melrouts/RetroConsole-LunaStation/exhibition/shot-apollo.png

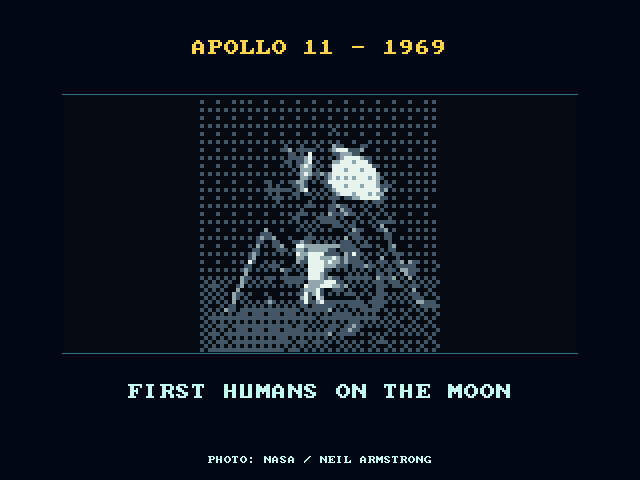
exhibition/shot-apollo.png
