melrouts/RetroConsole-LunaStation/hardware/board-photos/IMG_6732.jpeg

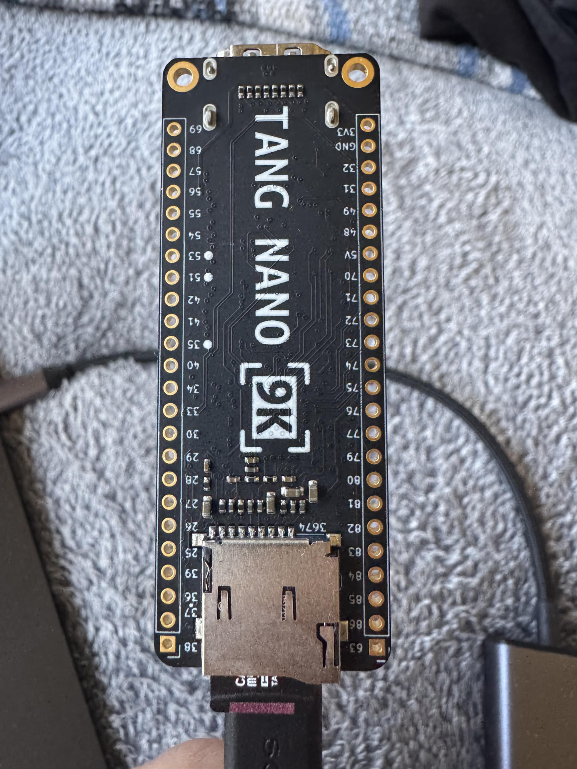
hardware/board-photos/IMG_6732.jpeg
