melrouts/RetroConsole-LunaStation/hardware/esp32-max98357a/photos/IMG_6813.jpeg

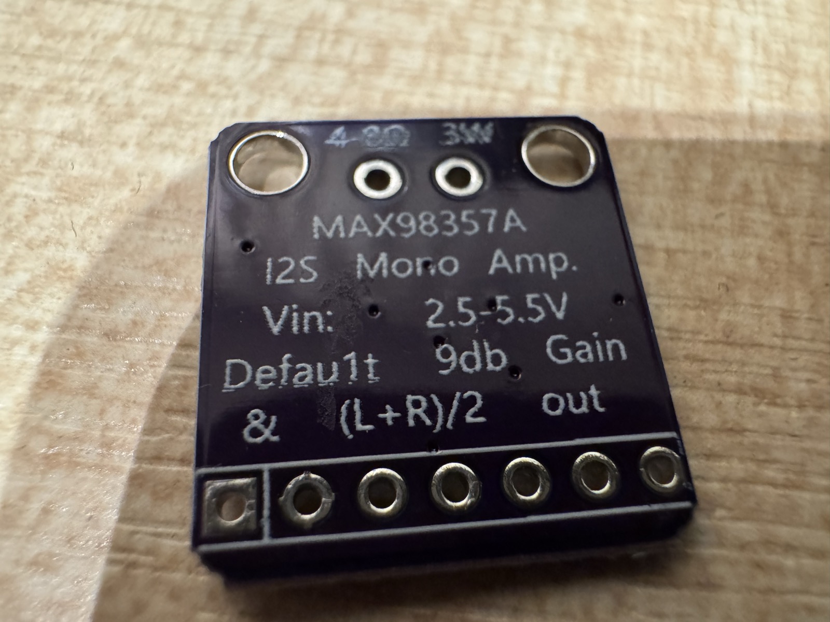
hardware/esp32-max98357a/photos/IMG_6813.jpeg
