melrouts/RetroConsole-LunaStation/hardware/luna-station-case/v1/previews/base_bottom.png

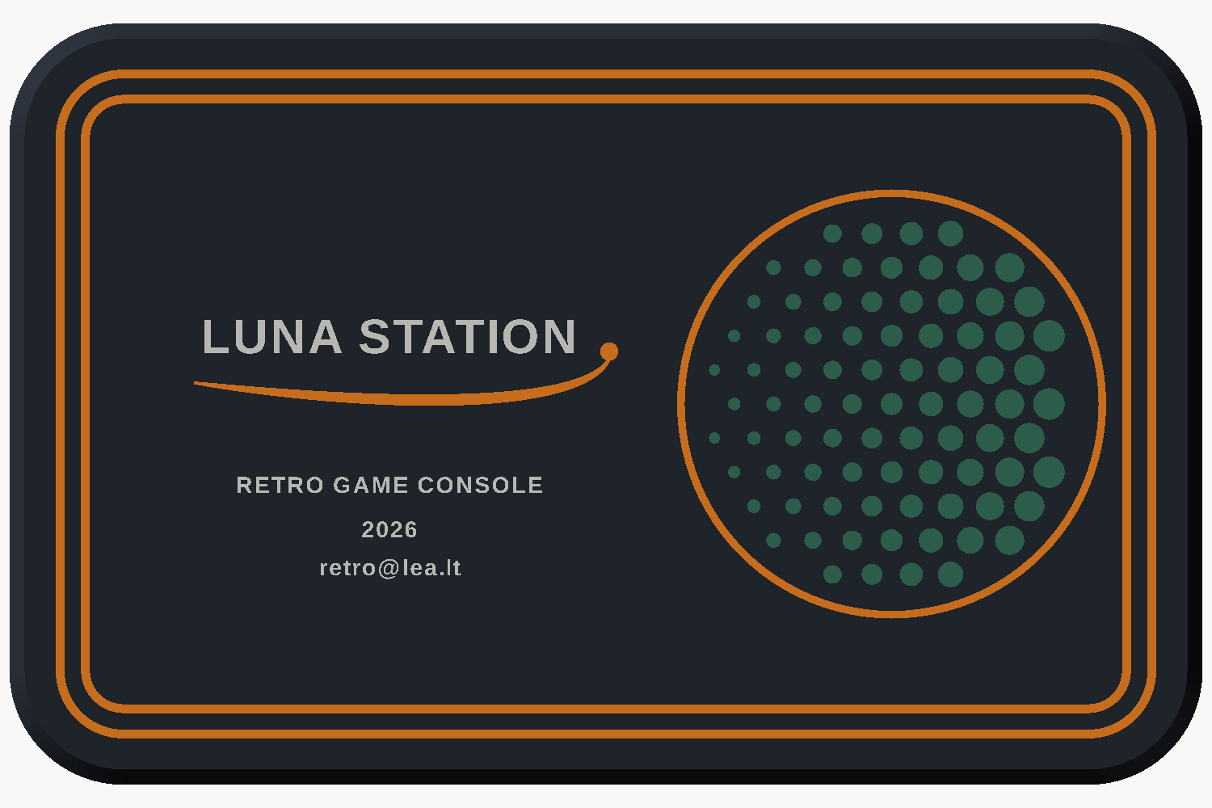
hardware/luna-station-case/v1/previews/base_bottom.png
