melrouts/RetroConsole-LunaStation/hardware/luna-station-case/v1/previews/base_options.png

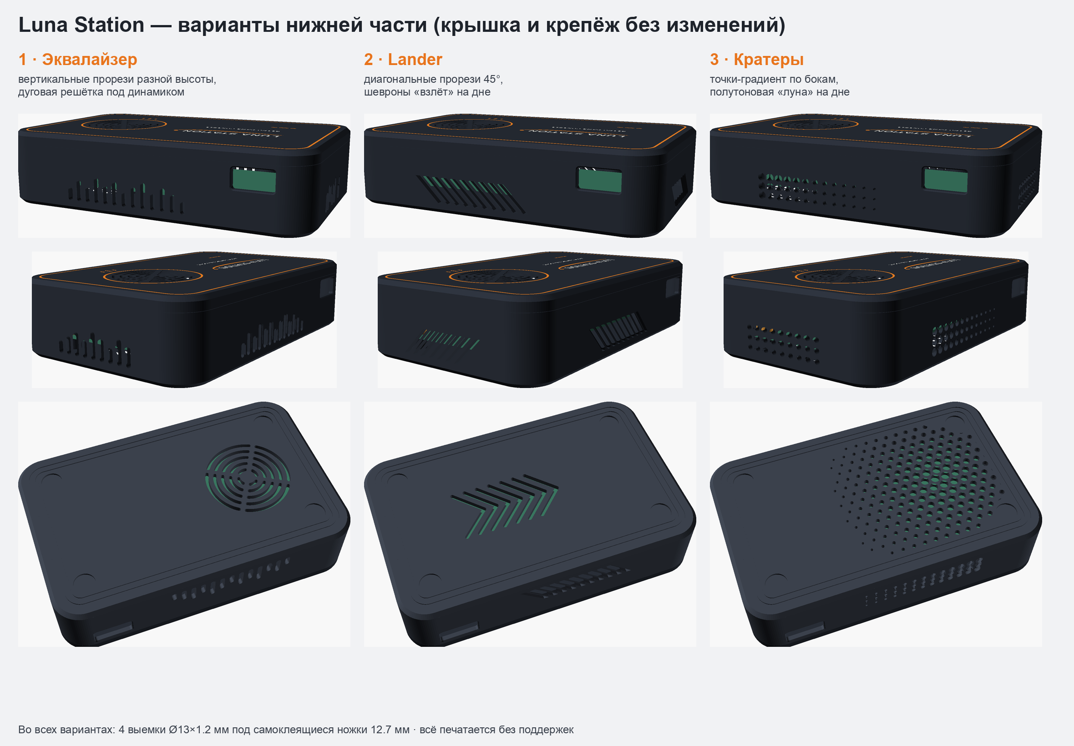
hardware/luna-station-case/v1/previews/base_options.png
