melrouts/RetroConsole-LunaStation/hardware/luna-station-case/v1/previews/base_side.png

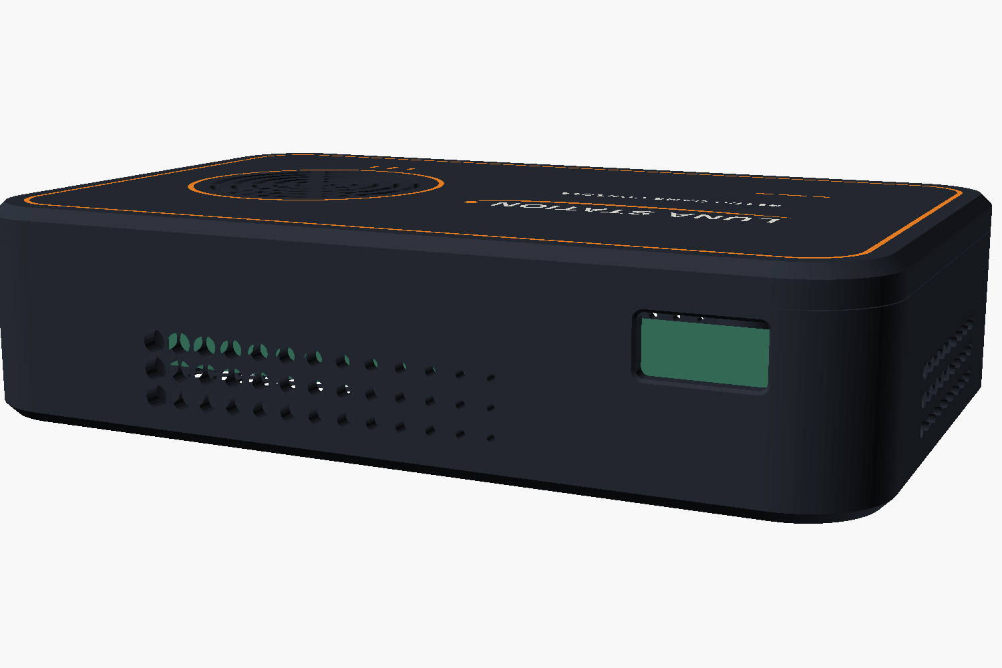
hardware/luna-station-case/v1/previews/base_side.png
