melrouts/RetroConsole-LunaStation/hardware/luna-station-case/v1/previews/base_under.png

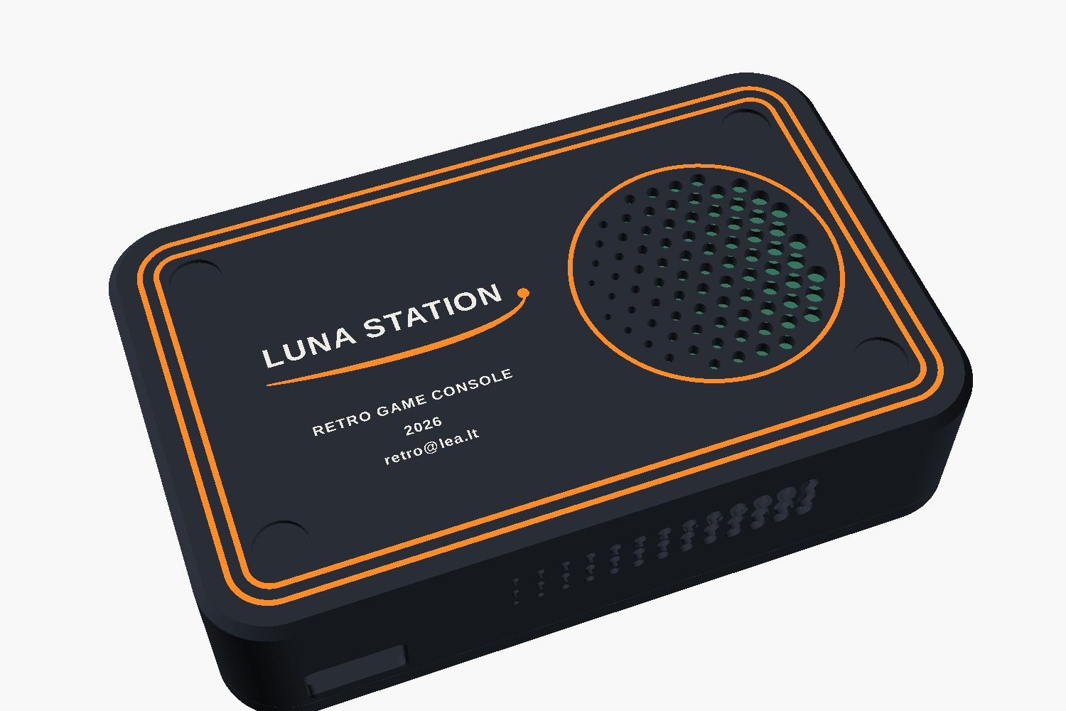
hardware/luna-station-case/v1/previews/base_under.png
