melrouts/RetroConsole-LunaStation/hardware/luna-station-case/v1/previews/fit_iso.png

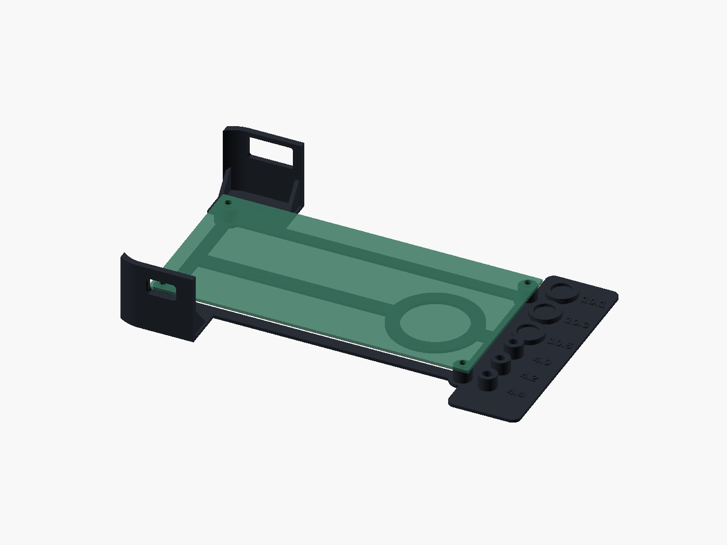
hardware/luna-station-case/v1/previews/fit_iso.png
