melrouts/RetroConsole-LunaStation/hardware/luna-station-case/v1/previews/fit_top.png

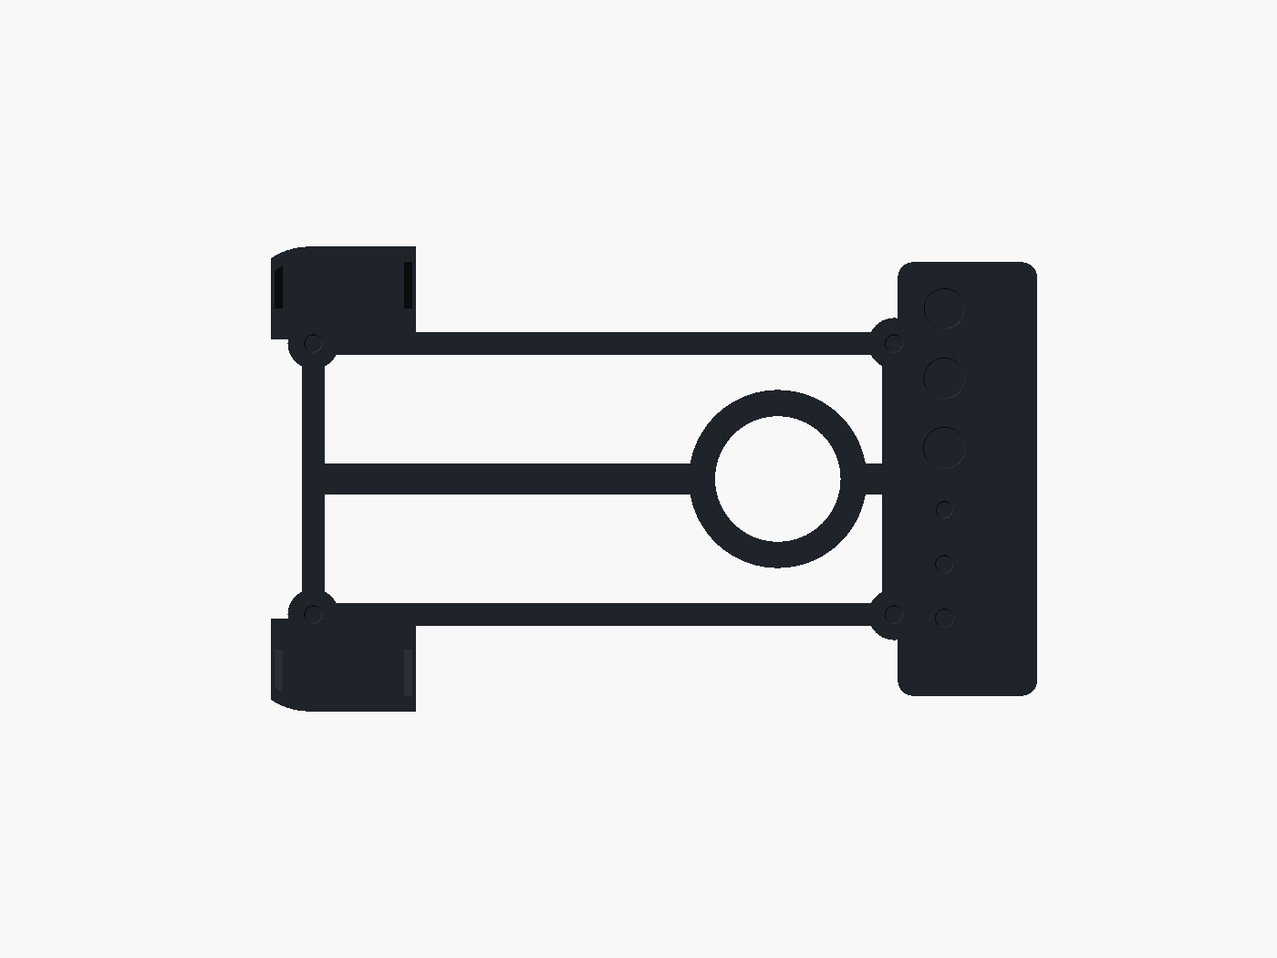
hardware/luna-station-case/v1/previews/fit_top.png
