melrouts/RetroConsole-LunaStation/hardware/luna-station-case/v1/previews/port_hdmi.png

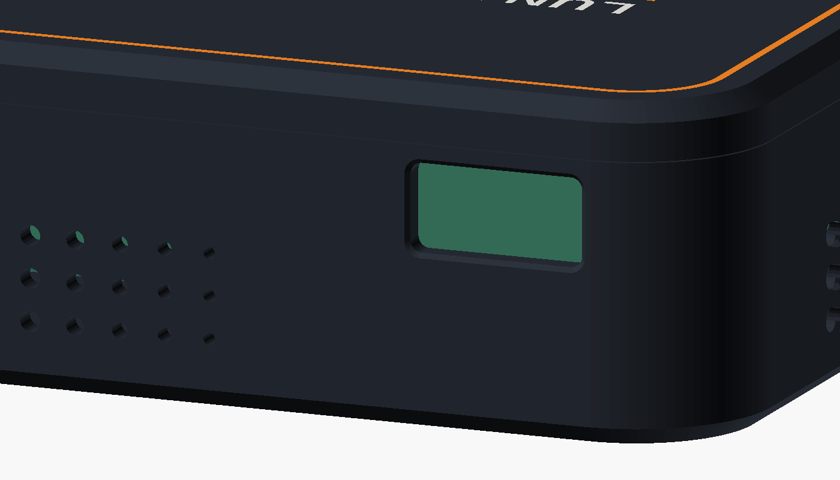
hardware/luna-station-case/v1/previews/port_hdmi.png
