melrouts/RetroConsole-LunaStation/hardware/luna-station-case/v1/previews/port_top.png

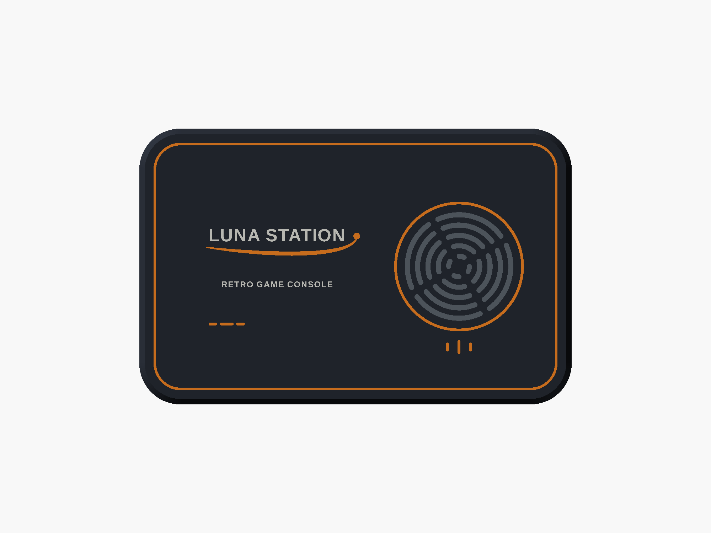
hardware/luna-station-case/v1/previews/port_top.png
