melrouts/RetroConsole-LunaStation/hardware/luna-station-case/v1/previews/port_usb_c.png

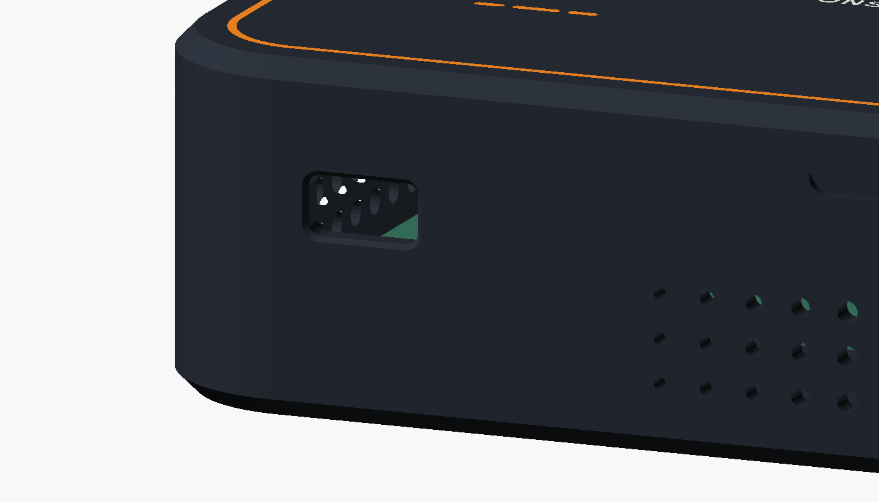
hardware/luna-station-case/v1/previews/port_usb_c.png
