melrouts/RetroConsole-LunaStation/hardware/luna-station-case/v1/previews/section.png

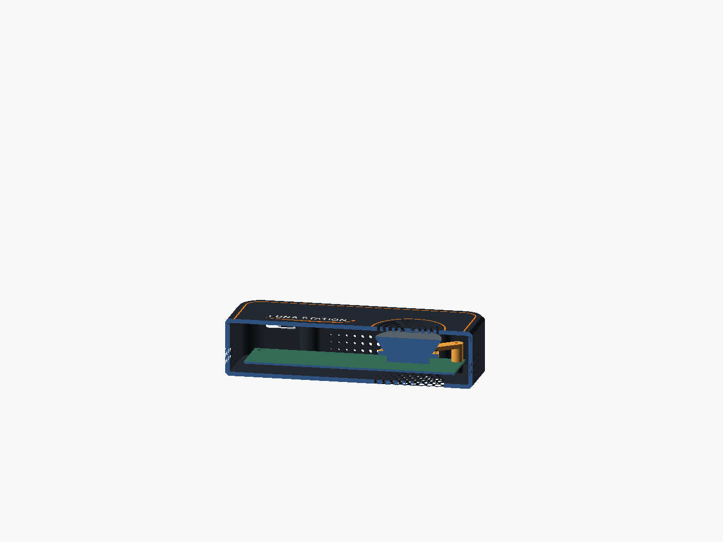
hardware/luna-station-case/v1/previews/section.png
