melrouts/RetroConsole-LunaStation/hardware/luna-station-case/v1/previews/variant_2_iso.png

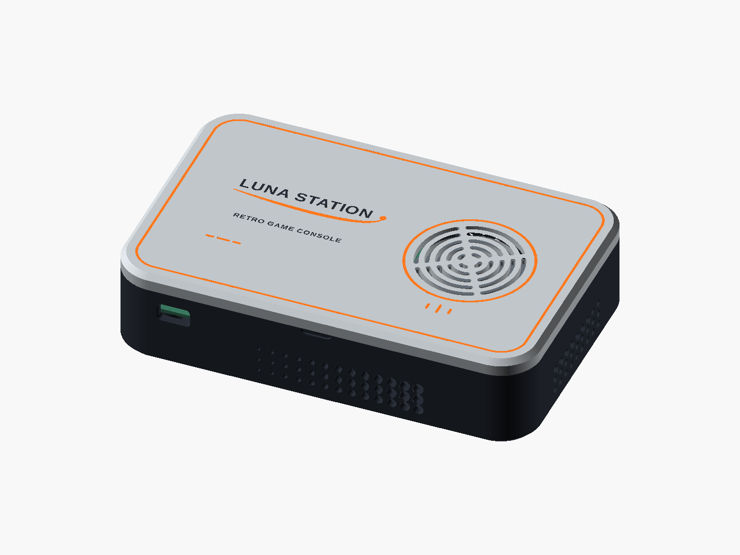
hardware/luna-station-case/v1/previews/variant_2_iso.png
