melrouts/RetroConsole-LunaStation/IMG_6783.jpeg

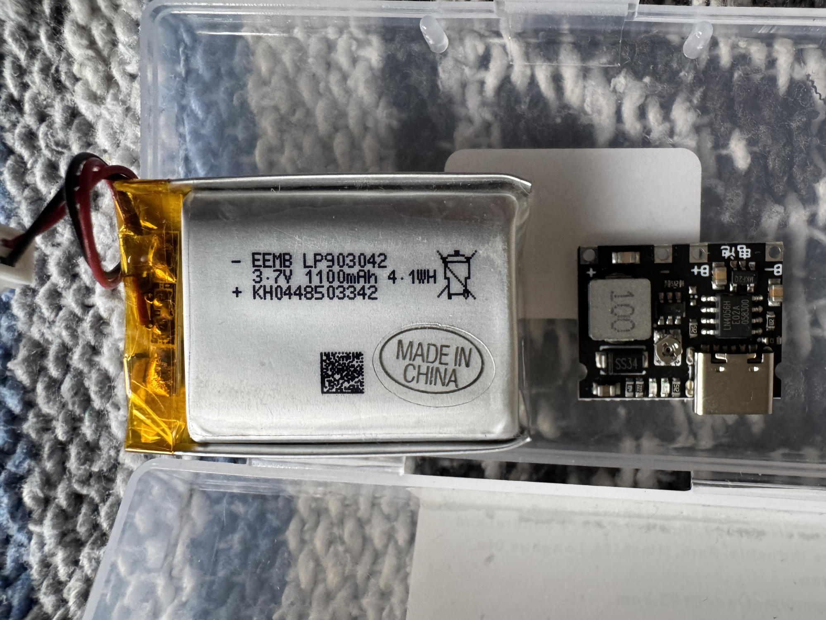
IMG_6783.jpeg
