melrouts/RetroConsole-LunaStation/photos/apollo11-nasa-6900956.jpg

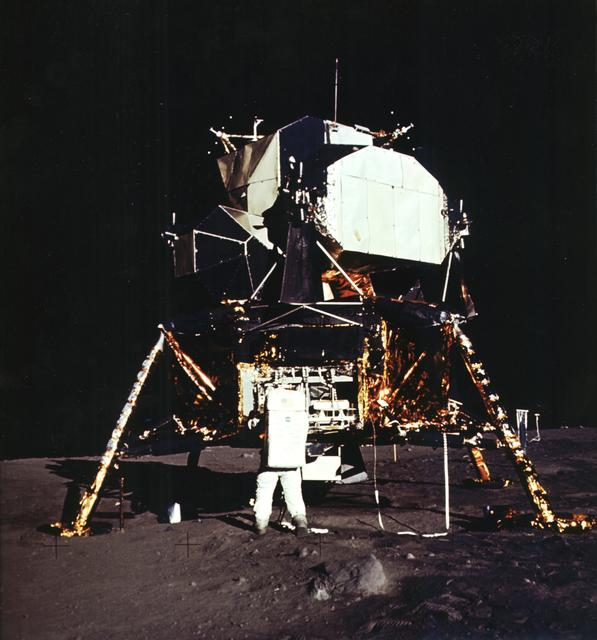
photos/apollo11-nasa-6900956.jpg
