melrouts/RetroConsole-LunaStation/photos/luna9-capsule.jpg

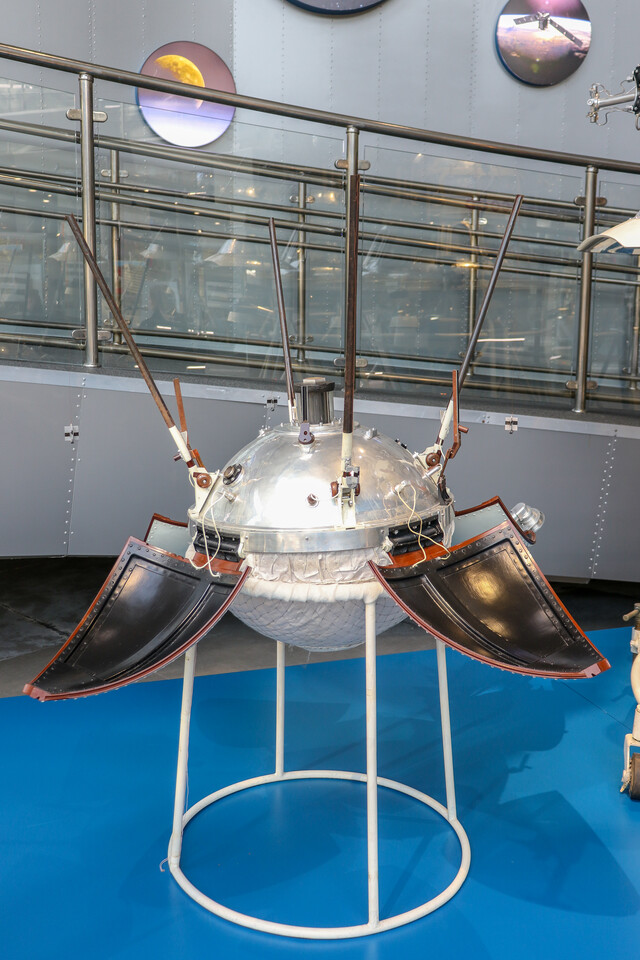
photos/luna9-capsule.jpg
