melrouts/RetroConsole-LunaStation/hardware/gamepad-power-holder/originals/gamepad_lid_original.stl

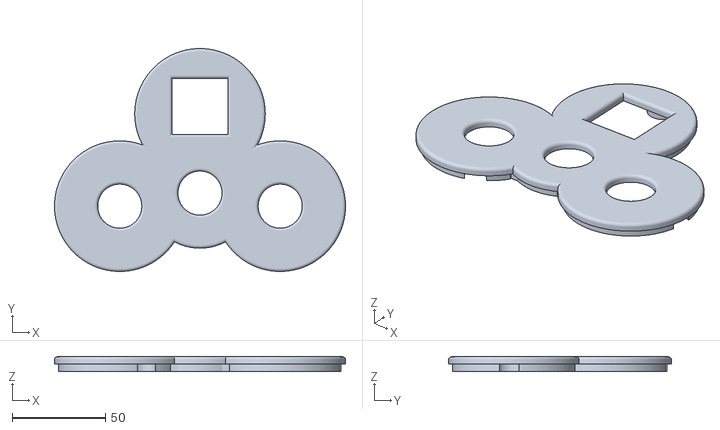
[picture p63: CAD file, 2026-11-11]
hardware/gamepad-power-holder/originals/gamepad_lid_original.stl
156.0 x 119.5 x 7.80
