melrouts/RetroConsole-LunaStation/hardware/gamepad-power-holder/v8/matrix_plate_v8.stl

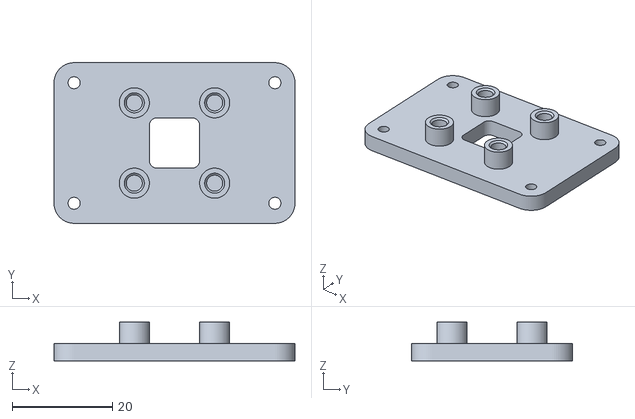
[picture p64: CAD file, 2026-11-11]
hardware/gamepad-power-holder/v8/matrix_plate_v8.stl
48.0 x 32.0 x 7.70
