melrouts/RetroConsole-LunaStation/hardware/luna-station-case/v1/checks/pcb.stl

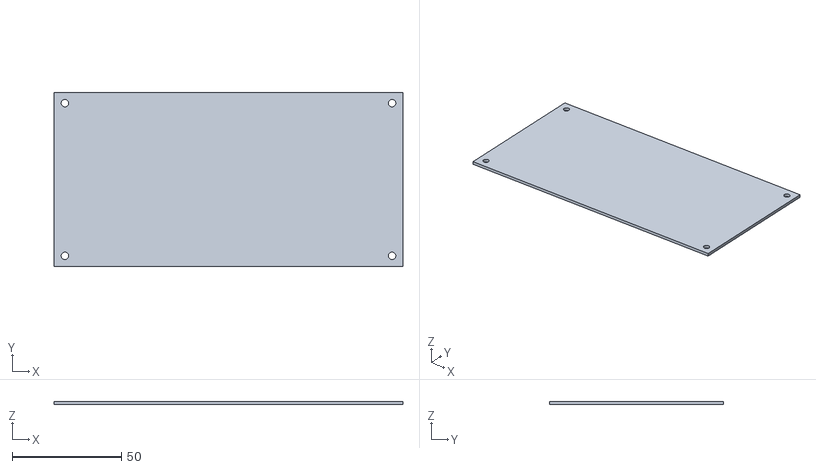
[picture p65: CAD file, 2026-11-11]
hardware/luna-station-case/v1/checks/pcb.stl
160.0 x 80.0 x 1.60
