melrouts/RetroConsole-LunaStation/hardware/luna-station-case/v1/luna_station_2_lid.3mf

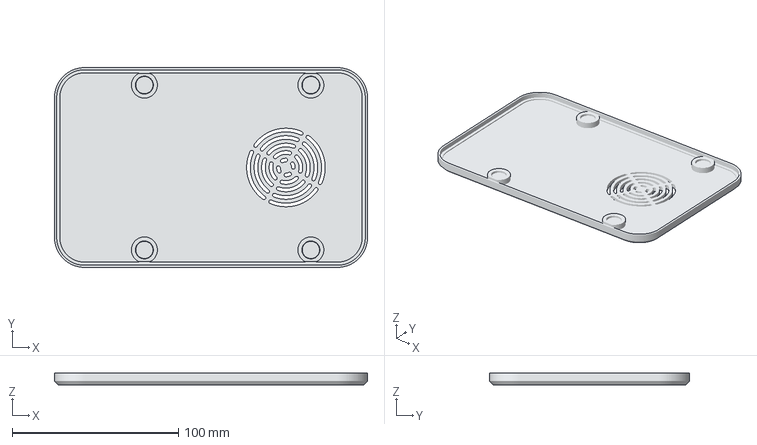
[picture p66: CAD file, 2026-11-11]
hardware/luna-station-case/v1/luna_station_2_lid.3mf
188.0 x 120.0 x 7.35 mm
