melrouts/RetroConsole-LunaStation/hardware/luna-station-case/v1/stl/bridge.stl

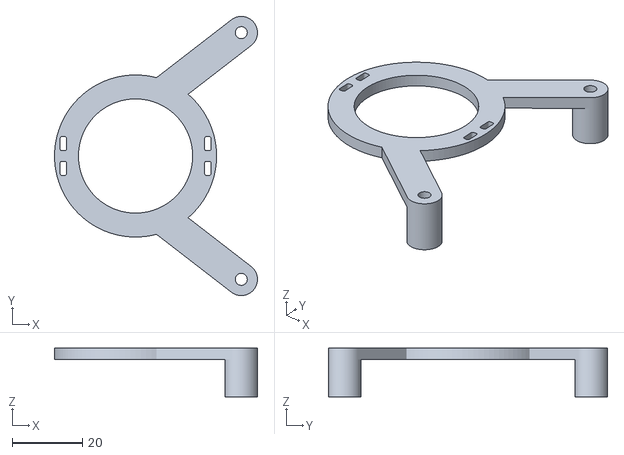
[picture p67: CAD file, 2026-11-11]
hardware/luna-station-case/v1/stl/bridge.stl
57.6 x 79.2 x 13.8
