melrouts/RetroConsole-LunaStation/hardware/luna9k-badge/luna9k_badge.stl

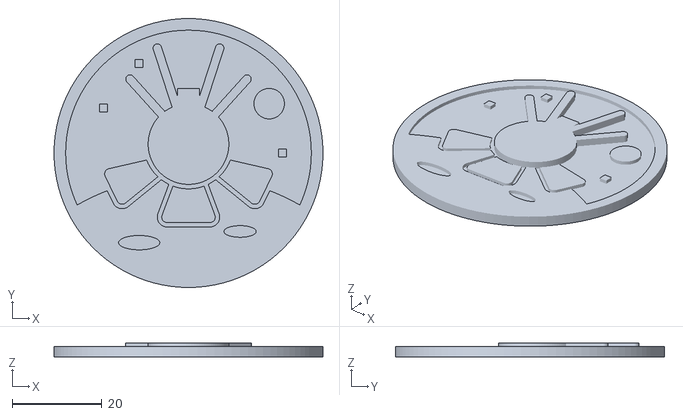
[picture p68: CAD file, 2026-11-11]
hardware/luna9k-badge/luna9k_badge.stl
60.0 x 60.0 x 3.20
