melrouts/RetroConsole-LunaStation/hardware/luna9k-badge/parts/luna9k_badge_relief.stl

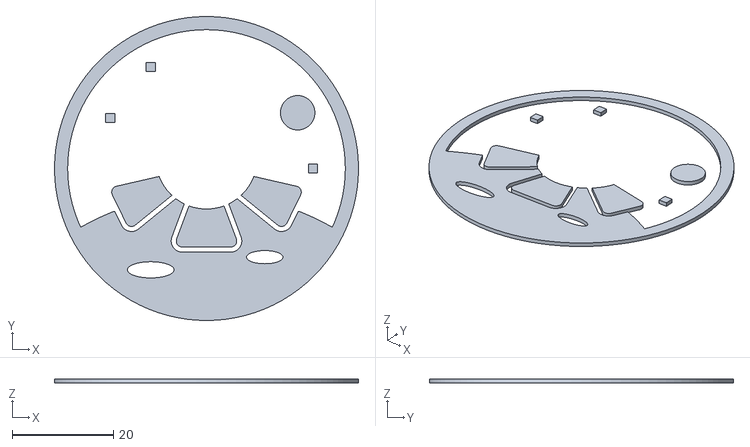
[picture p69: CAD file, 2026-11-11]
hardware/luna9k-badge/parts/luna9k_badge_relief.stl
60.0 x 60.0 x 0.8
