melrouts/RetroConsole-LunaStation/hardware/luna9k-badge/two-color/luna9k_badge_2color_top.stl

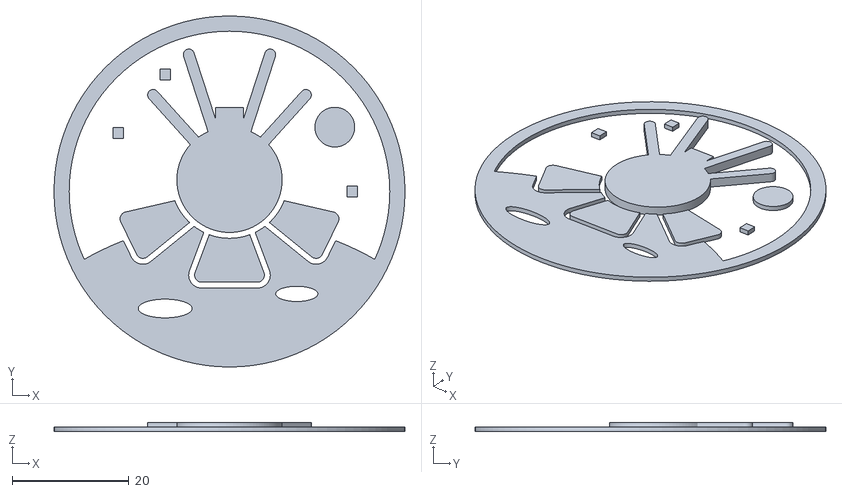
[picture p70: CAD file, 2026-11-11]
hardware/luna9k-badge/two-color/luna9k_badge_2color_top.stl
60.0 x 60.0 x 1.60
