melrouts/RetroConsole-LunaStation/hardware/gamepad-power-holder/originals/gamepad_case_original.stl

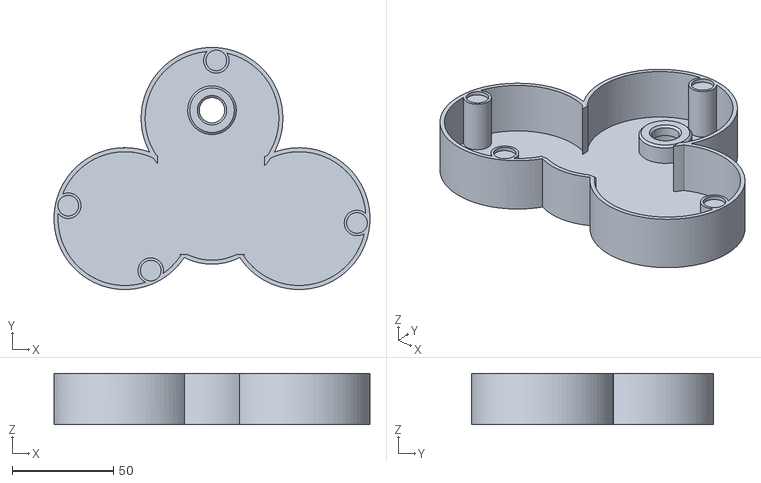
[picture p71: CAD file, 2026-11-11]
hardware/gamepad-power-holder/originals/gamepad_case_original.stl
156.0 x 119.5 x 25.2
