melrouts/RetroConsole-LunaStation/hardware/luna-station-case/v1/checks/speaker.stl

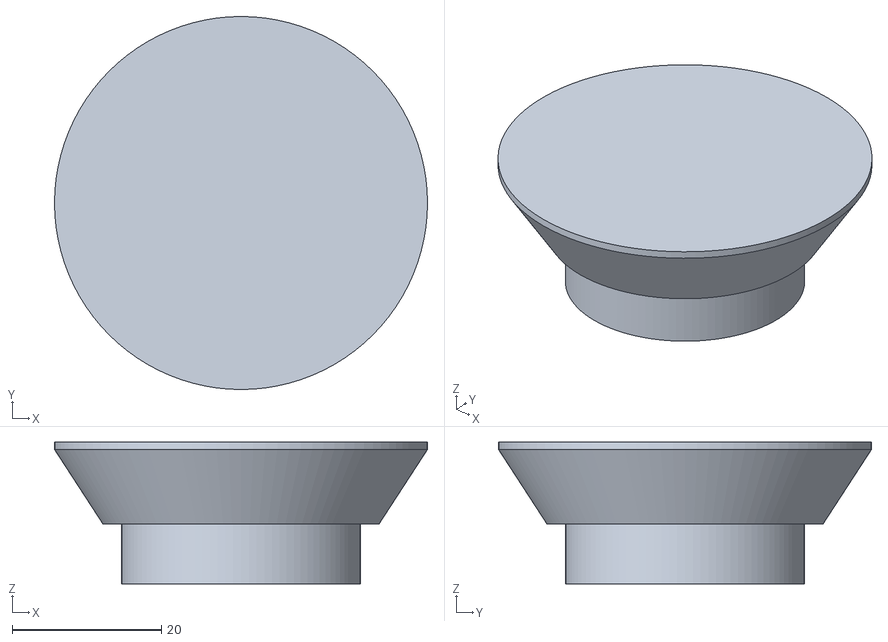
[picture p72: CAD file, 2026-11-11]
hardware/luna-station-case/v1/checks/speaker.stl
50.0 x 50.0 x 19.0
