melrouts/RetroConsole-LunaStation/hardware/luna-station-case/v1/stl/base_accent.stl

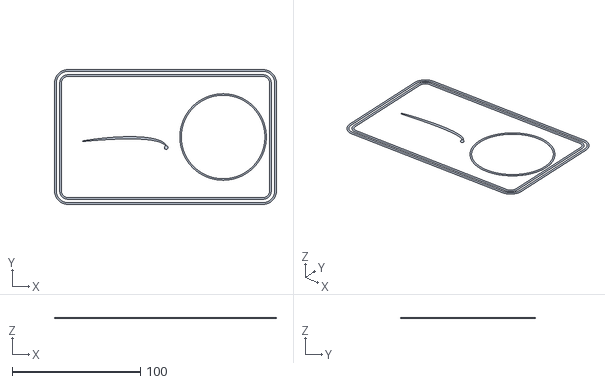
[picture p73: CAD file, 2026-11-11]
hardware/luna-station-case/v1/stl/base_accent.stl
173.4 x 105.4 x 0.6
