melrouts/RetroConsole-LunaStation/hardware/luna9k-badge/parts/luna9k_badge_lander.stl

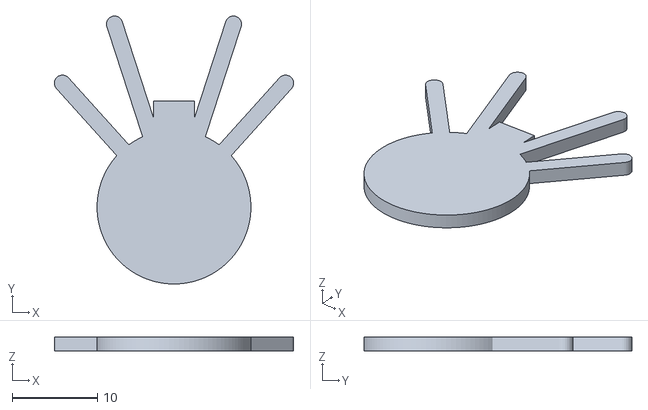
[picture p74: CAD file, 2026-11-11]
hardware/luna9k-badge/parts/luna9k_badge_lander.stl
28.0 x 31.3 x 1.60
