melrouts/RetroConsole-LunaStation/hardware/luna-station-case/v1/luna_station_3_base.3mf

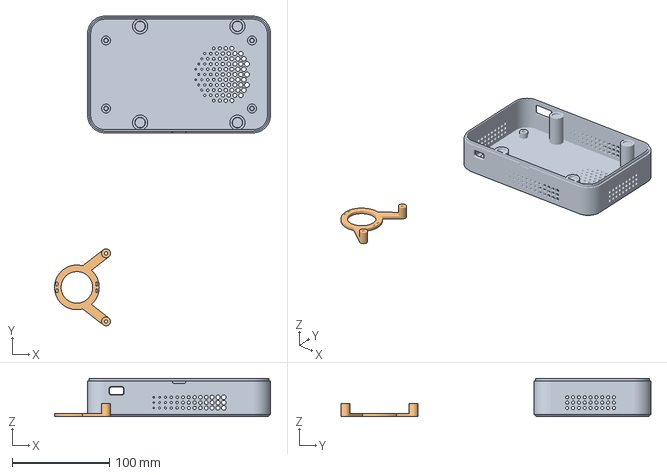
[picture p76: CAD file, 2026-11-11]
hardware/luna-station-case/v1/luna_station_3_base.3mf
222.0 x 318.4 x 39.5 mm
Base - three colours
bridge
