melrouts/RetroConsole-LunaStation/hardware/luna-station-case/v1/stl/lid.stl

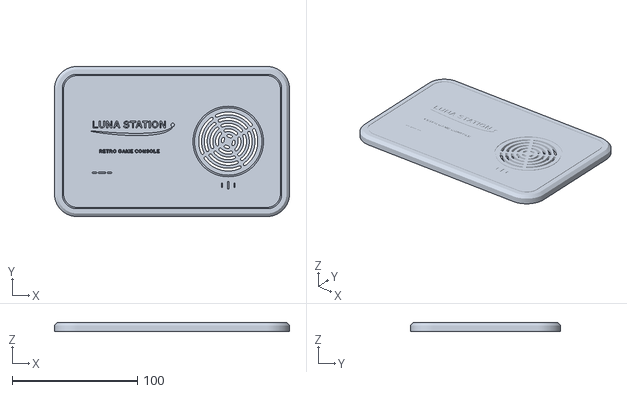
[picture p77: CAD file, 2026-11-11]
hardware/luna-station-case/v1/stl/lid.stl
188.0 x 120.0 x 7.35
