melrouts/RetroConsole-LunaStation/hardware/luna-station-case/v1/luna_station_1_concept.3mf

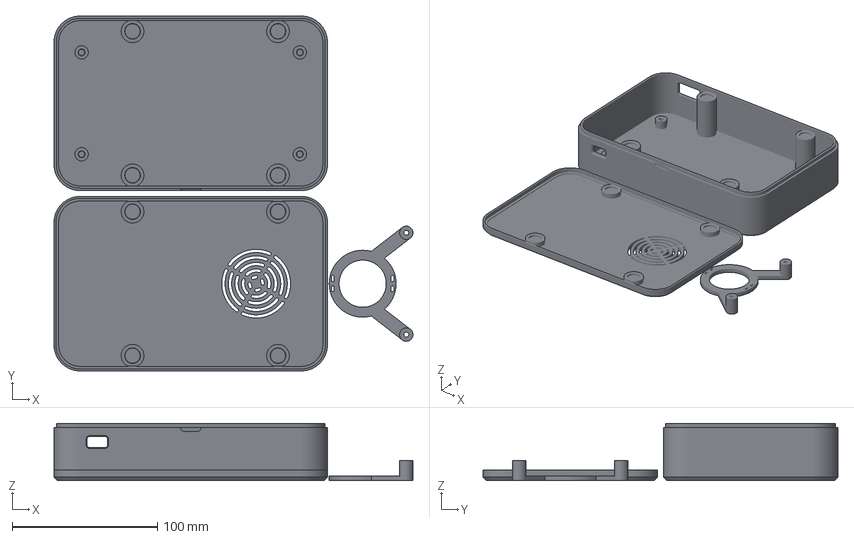
[picture p78: CAD file, 2026-11-11]
hardware/luna-station-case/v1/luna_station_1_concept.3mf
246.8 x 244.0 x 39.5 mm
Lid - three colours
bottom
bridge
