melrouts/RetroConsole-LunaStation/hardware/luna-station-case/v1/stl/fit_test.stl

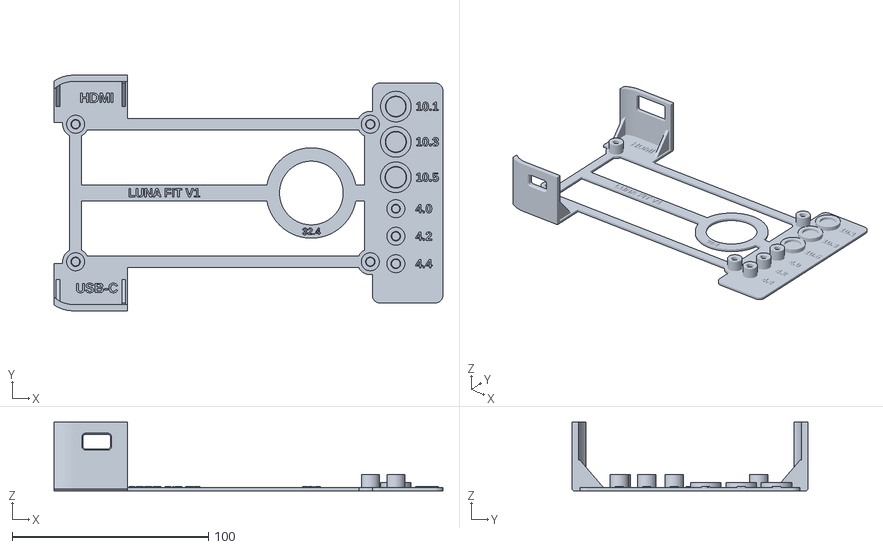
[picture p79: CAD file, 2026-11-11]
hardware/luna-station-case/v1/stl/fit_test.stl
198.0 x 120.0 x 34.9
