melrouts/RetroConsole-LunaStation/hardware/luna-station-case/v1/stl/text.stl

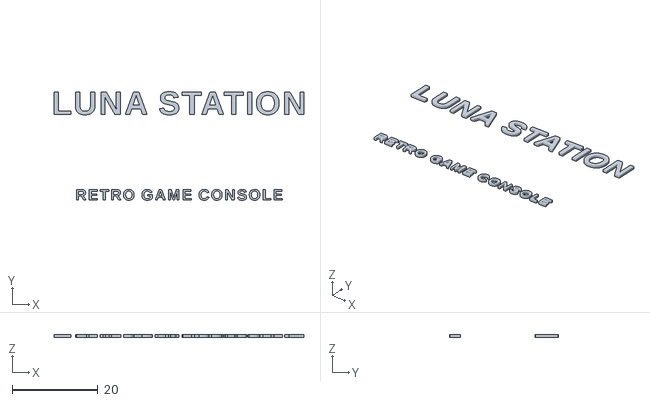
[picture p80: CAD file, 2026-11-11]
hardware/luna-station-case/v1/stl/text.stl
58.2 x 25.3 x 0.6
