melrouts/RetroConsole-LunaStation/hardware/luna-station-case/v1/stl/bottom.stl

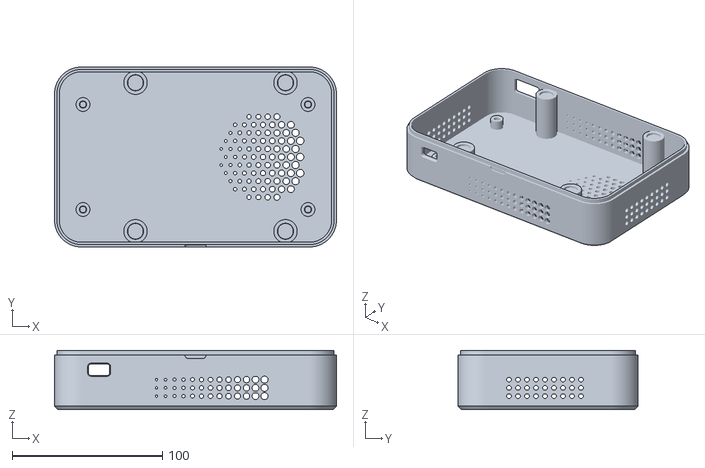
[picture p81: CAD file, 2026-11-11]
hardware/luna-station-case/v1/stl/bottom.stl
188.0 x 120.0 x 39.5
