melrouts/RetroConsole-LunaStation/hardware/luna-station-case/v1/stl/base_text.stl

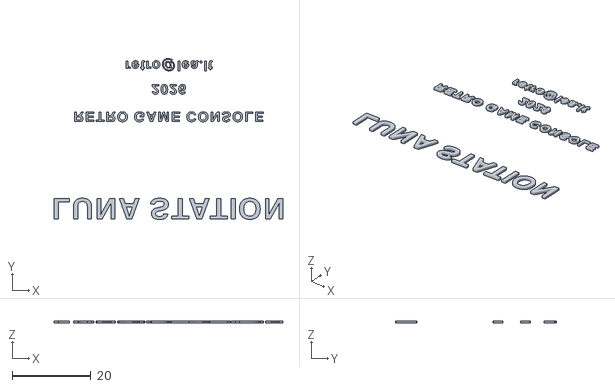
[picture p82: CAD file, 2026-11-11]
hardware/luna-station-case/v1/stl/base_text.stl
58.2 x 40.9 x 0.6
