melrouts/RetroConsole-LunaStation/hardware/luna-station-case/v1/luna_station_1_base.3mf

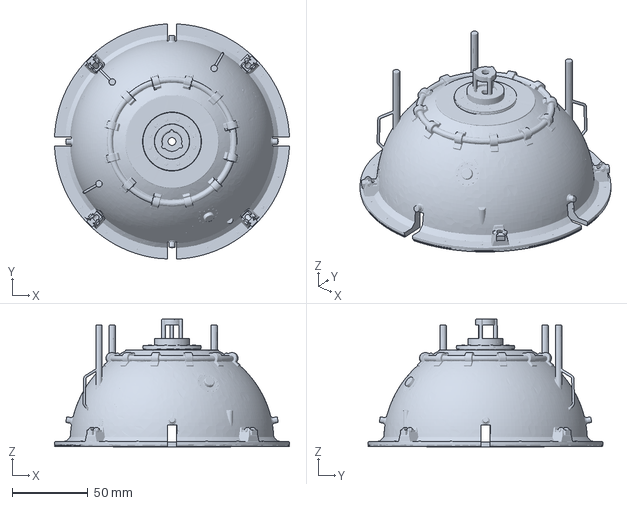
[picture p83: CAD file, 2026-11-11]
hardware/luna-station-case/v1/luna_station_1_base.3mf
155.4 x 155.4 x 84.4 mm
