melrouts/RetroConsole-LunaStation/hardware/luna-station-case/v1/stl/accent.stl

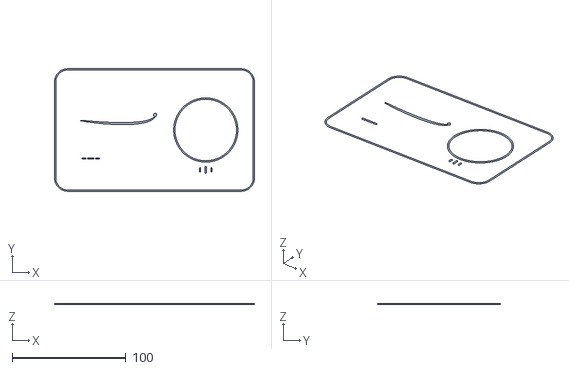
[picture p84: CAD file, 2026-11-11]
hardware/luna-station-case/v1/stl/accent.stl
175.6 x 107.6 x 0.6
