melrouts/RetroConsole-LunaStation/hardware/luna-station-case/v1/luna_station_2_base.3mf

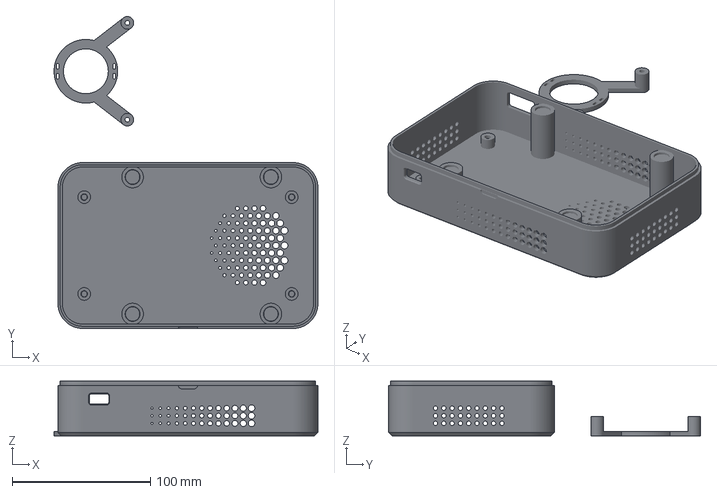
[picture p85: CAD file, 2026-11-11]
hardware/luna-station-case/v1/luna_station_2_base.3mf
190.8 x 225.6 x 39.5 mm
Base - three colours
bridge
