melrouts/RetroConsole-LunaStation/(list of files, cad)

Other CAD files:
hardware/luna-station-case/v1/luna_station_1_lid.3mf
hardware/luna9k-badge/two-color/luna9k_badge_2color.stl
hardware/luna-station-case/v1/luna_station_3_lid.3mf
hardware/luna-station-case/v1/luna_station_3_concept.3mf
hardware/luna-station-case/v1/luna_station_2_concept.3mf
hardware/luna-station-case/v1/luna_station_fit_test.3mf
hardware/gamepad-power-holder/v1/gamepad_case.scad
hardware/gamepad-power-holder/v1/gamepad_case_rounded.stl
hardware/gamepad-power-holder/v1/gamepad_case_with_holder.stl
hardware/gamepad-power-holder/v1/gamepad_holder_positioned.stl
hardware/gamepad-power-holder/v1/gamepad_power_holder.scad
hardware/gamepad-power-holder/v1/gamepad_power_holder.stl
hardware/gamepad-power-holder/v1/usb_c_case_cutter.stl
hardware/gamepad-power-holder/v1/usb_c_cutter_positioned.stl
hardware/gamepad-power-holder/v2/button_profile_v2.scad
hardware/gamepad-power-holder/v2/gamepad_case_v2.scad
hardware/gamepad-power-holder/v2/gamepad_case_v2.stl
hardware/gamepad-power-holder/v2/gamepad_case_v2_pod.stl
hardware/gamepad-power-holder/v2/gamepad_case_v2_shell.stl
hardware/gamepad-power-holder/v2/gamepad_case_v2_thin_raw.stl
hardware/gamepad-power-holder/v3/gamepad_holder_v3.scad
hardware/gamepad-power-holder/v3/gamepad_holder_v3.stl
hardware/gamepad-power-holder/v4/button_profile_v4.scad
hardware/gamepad-power-holder/v4/gamepad_case_v4.scad
hardware/gamepad-power-holder/v4/gamepad_case_v4.stl
hardware/gamepad-power-holder/v4/gamepad_case_v4_raw.stl
hardware/gamepad-power-holder/v4/gamepad_lid_v4.stl
hardware/gamepad-power-holder/v5/gamepad_case_v5.scad
hardware/gamepad-power-holder/v5/gamepad_case_v5.stl
hardware/gamepad-power-holder/v5/gamepad_case_v5_raw.stl
hardware/gamepad-power-holder/v5/gamepad_lid_v5.scad
hardware/gamepad-power-holder/v5/gamepad_lid_v5.stl
hardware/gamepad-power-holder/v5/gamepad_lid_v5_accent.stl
hardware/gamepad-power-holder/v5/gamepad_lid_v5_base.stl
hardware/gamepad-power-holder/v5/gamepad_lid_v5_text.stl
hardware/gamepad-power-holder/v5/luna_station_v5.3mf
hardware/gamepad-power-holder/v5/luna_station_v5_face_up.3mf
hardware/gamepad-power-holder/v6/color_options/color_preview_v6.scad
hardware/gamepad-power-holder/v6/gamepad_lid_v6.scad
hardware/gamepad-power-holder/v6/gamepad_lid_v6.stl
hardware/gamepad-power-holder/v6/gamepad_lid_v6_accent.stl
hardware/gamepad-power-holder/v6/gamepad_lid_v6_text.stl
hardware/gamepad-power-holder/v6/lid_v6_geometry.scad
hardware/gamepad-power-holder/v6/luna_station_v6.3mf
hardware/gamepad-power-holder/v7/gamepad_case_v7.scad
hardware/gamepad-power-holder/v7/gamepad_case_v7.stl
hardware/gamepad-power-holder/v7/luna_station_v7.3mf
