melrouts/RetroConsole-LunaStation/hardware/esp32-max98357a/esp32-max98357a-photo-wiring.png

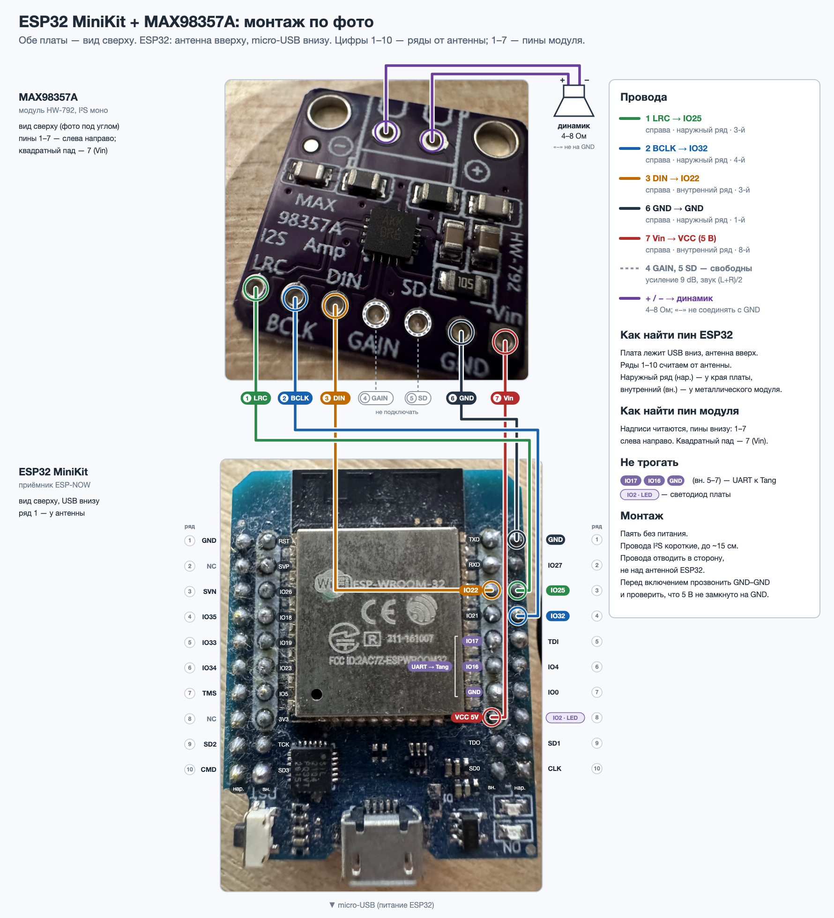
hardware/esp32-max98357a/esp32-max98357a-photo-wiring.png
