melrouts/RetroConsole-LunaStation/hardware/esp32-max98357a/esp32-max98357a-wiring.png

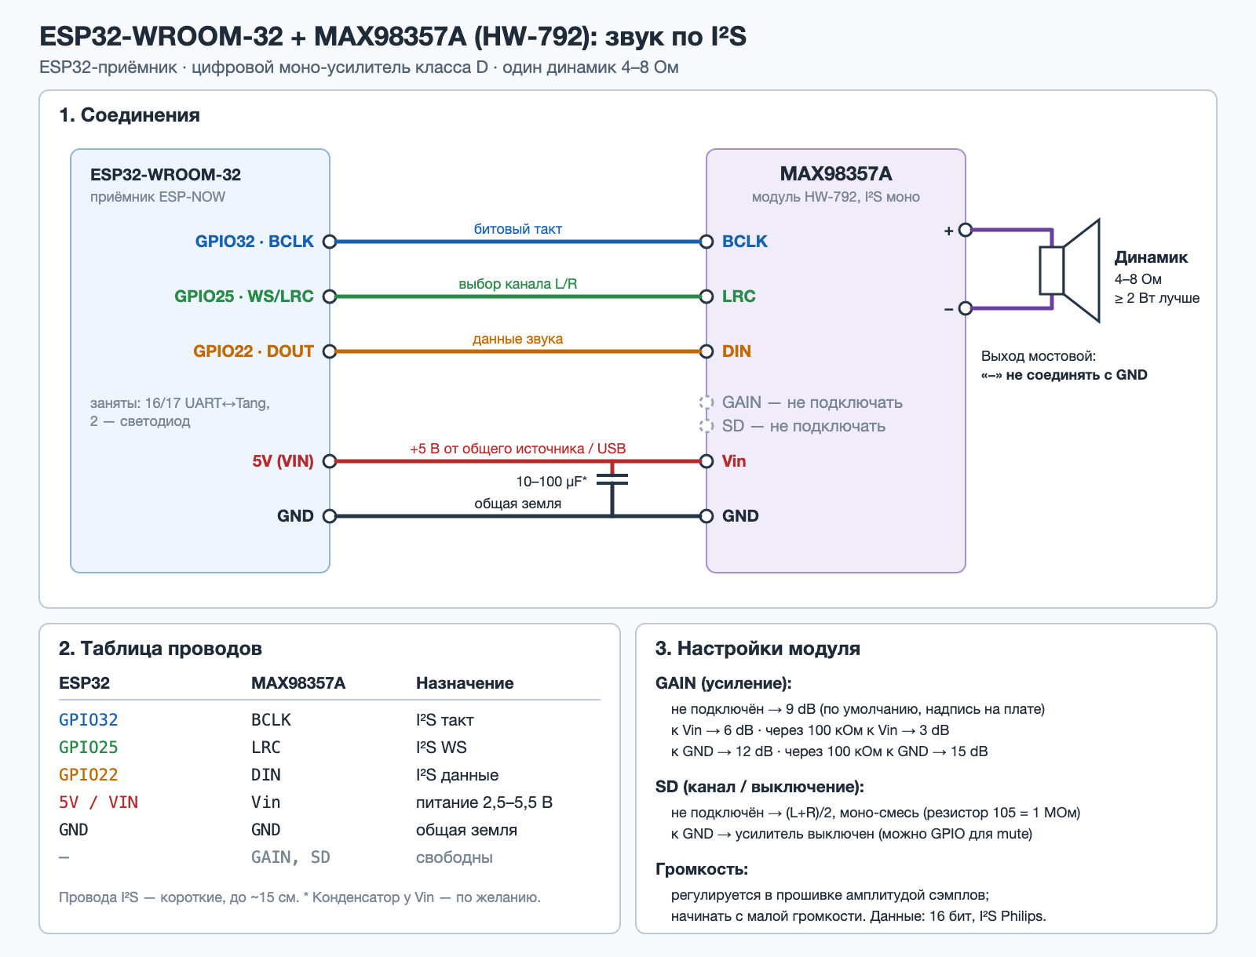
hardware/esp32-max98357a/esp32-max98357a-wiring.png
